Limpan/deskamp/DesktopAMP.kicad_pcb

## KiCad design DesktopAMP.kicad_pcb (2022-02-22)

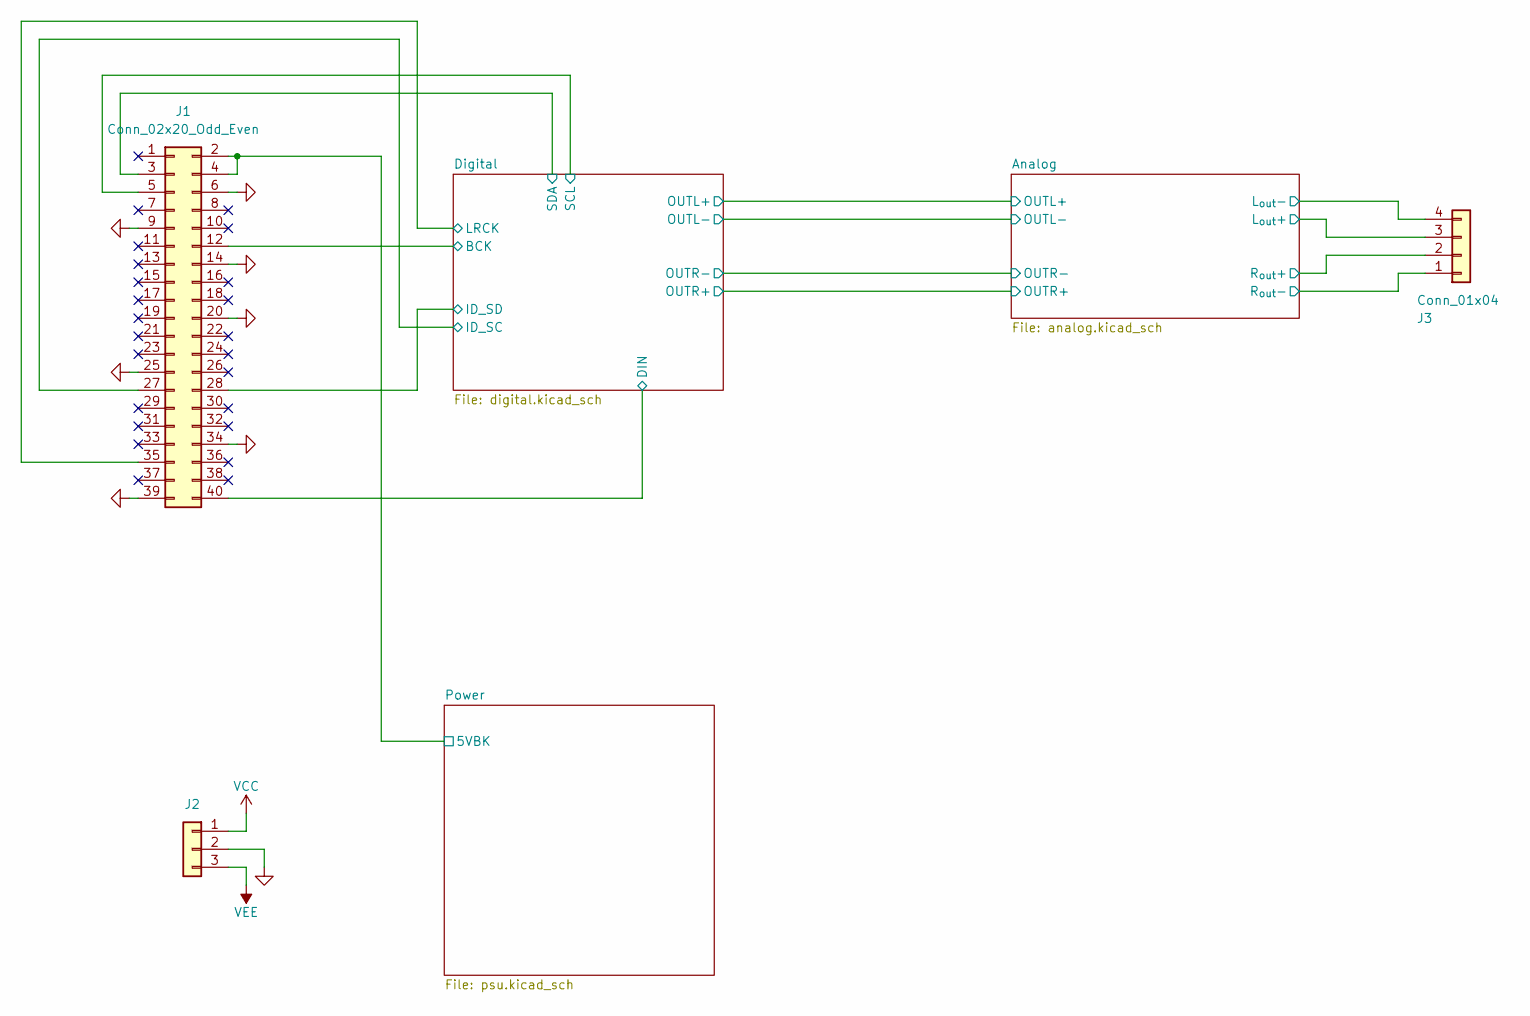
[picture p1: schematic DesktopAMP.kicad_sch]

Parts:
J1: Conn_02x20_Odd_Even; RPi_Zero_2W_SMD
J2: Conn_01x03; PhoenixContact_MSTBVA_2,5_3-G_1x03_P5.00mm_Vertical
J3: Conn_01x04; PhoenixContact_MSTBVA_2,5_4-G_1x04_P5.00mm_Vertical

Connections:
/Analog/L_{out}+: J3.3; also elsewhere on the board
/Analog/R_{out}+: J3.2; also elsewhere on the board
/Digital/BCK: J1.12; also elsewhere on the board
/Digital/DIN: J1.40; also elsewhere on the board
/Digital/ID_SC: J1.27; also elsewhere on the board
/Digital/ID_SD: J1.28; also elsewhere on the board
/Digital/LRCK: J1.35; also elsewhere on the board
/Digital/SCL: J1.5; also elsewhere on the board
/Digital/SDA: J1.3; also elsewhere on the board
/Power/5VBK: J1.2, J1.4; also elsewhere on the board
GND: J1.6, J1.9, J1.14, J1.20, J1.25, J1.34, J1.39, J2.2, J3.1, J3.4; also elsewhere on the board
VCC: J2.1; also elsewhere on the board
VEE: J2.3; also elsewhere on the board

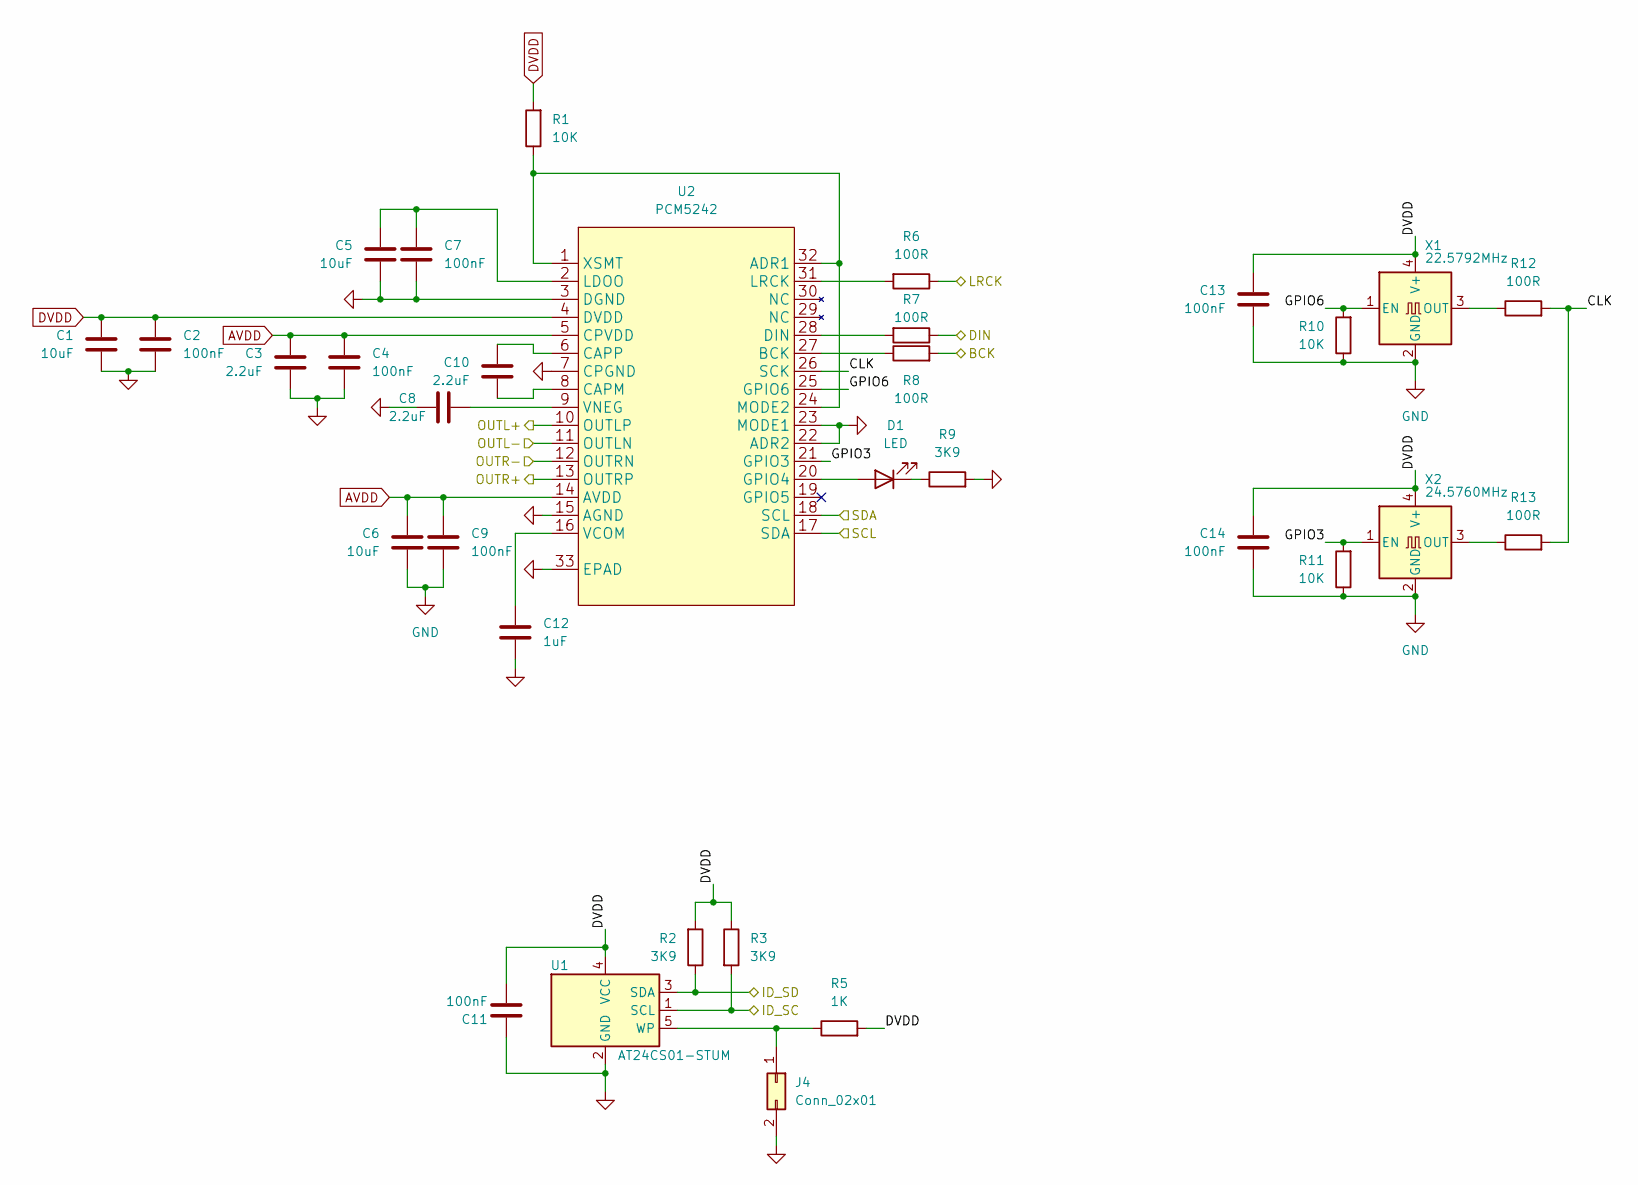
[picture p2: schematic digital.kicad_sch]

Parts:
C1, C5, C6: 10uF; C_0805_2012Metric
C2, C4, C7, C9, C11, C13, C14: 100nF; C_0603_1608Metric
C3, C8, C10: 2.2uF; C_0805_2012Metric
C12: 1uF; C_0805_2012Metric
D1: LED; LED_0805_2012Metric
J4: Conn_02x01; PinHeader_1x02_P2.54mm_Vertical
R1, R10, R11: 10K; R_0805_2012Metric
R2, R3, R9: 3K9; R_0805_2012Metric
R5: 1K; R_0805_2012Metric
R6, R7, R8, R12, R13: 100R; R_0805_2012Metric
U1: AT24CS01-STUM; SOT-23-5
U2: PCM5242; Texas_S-PVQFN-N32_EP3.45x3.45mm_ThermalVias
X1: 22.5792MHz; Oscillator_SMD_EuroQuartz_XO53-4Pin_5.0x3.2mm
X2: 24.5760MHz; Oscillator_SMD_EuroQuartz_XO53-4Pin_5.0x3.2mm

Connections:
/Analog/OUTL+: U2.10 (OUTLP); also elsewhere on the board
/Analog/OUTL-: U2.11 (OUTLN); also elsewhere on the board
/Analog/OUTR+: U2.13 (OUTRP); also elsewhere on the board
/Analog/OUTR-: U2.12 (OUTRN); also elsewhere on the board
/Digital/BCK: R8.2; also elsewhere on the board
/Digital/CLK: R12.2, R13.2, U2.26 (SCK)
/Digital/DIN: R7.1; also elsewhere on the board
/Digital/GPIO3: R11.2, U2.21 (GPIO3), X2.1 (EN)
/Digital/GPIO6: R10.2, U2.25 (GPIO6), X1.1 (EN)
/Digital/ID_SC: R3.2, U1.1 (SCL); also elsewhere on the board
/Digital/ID_SD: R2.1, U1.3 (SDA); also elsewhere on the board
/Digital/LRCK: R6.1; also elsewhere on the board
/Digital/SCL: U2.17 (SDA); also elsewhere on the board
/Digital/SDA: U2.18 (SCL); also elsewhere on the board
AVDD: C3.1, C4.1, C6.1, C9.1, U2.5 (CPVDD), U2.14 (AVDD); also elsewhere on the board
DVDD: C1.1, C2.1, C11.2, C13.2, C14.2, R1.2, R2.2, R3.1, R5.2, U1.4 (VCC), U2.4 (DVDD), X1.4 (V+), X2.4 (V+); also elsewhere on the board
GND: C1.2, C2.2, C3.2, C4.2, C5.2, C6.2, C7.2, C8.1, C9.2, C11.1, C12.2, C13.1, C14.1, J4.2, R9.2, R10.1, R11.1, U1.2 (GND), U2.3 (DGND), U2.7 (CPGND), U2.15 (AGND), U2.22 (ADR2), U2.23 (MODE1), U2.33 (EPAD), X1.2 (GND), X2.2 (GND); also elsewhere on the board
unnamed: C5.1, C7.1, U2.2 (LDOO)
unnamed: C8.2, U2.9 (VNEG)
unnamed: C10.1, U2.6 (CAPP)
unnamed: C10.2, U2.8 (CAPM)
unnamed: C12.1, U2.16 (VCOM)
unnamed: D1.1 (K), R9.1
unnamed: D1.2 (A), U2.20 (GPIO4)
unnamed: J4.1, R5.1, U1.5 (WP)
unnamed: R1.1, U2.1 (XSMT), U2.24 (MODE2), U2.32 (ADR1)
unnamed: R6.2, U2.31 (LRCK)
unnamed: R7.2, U2.28 (DIN)
unnamed: R8.1, U2.27 (BCK)
unnamed: R12.1, X1.3 (OUT)
unnamed: R13.1, X2.3 (OUT)

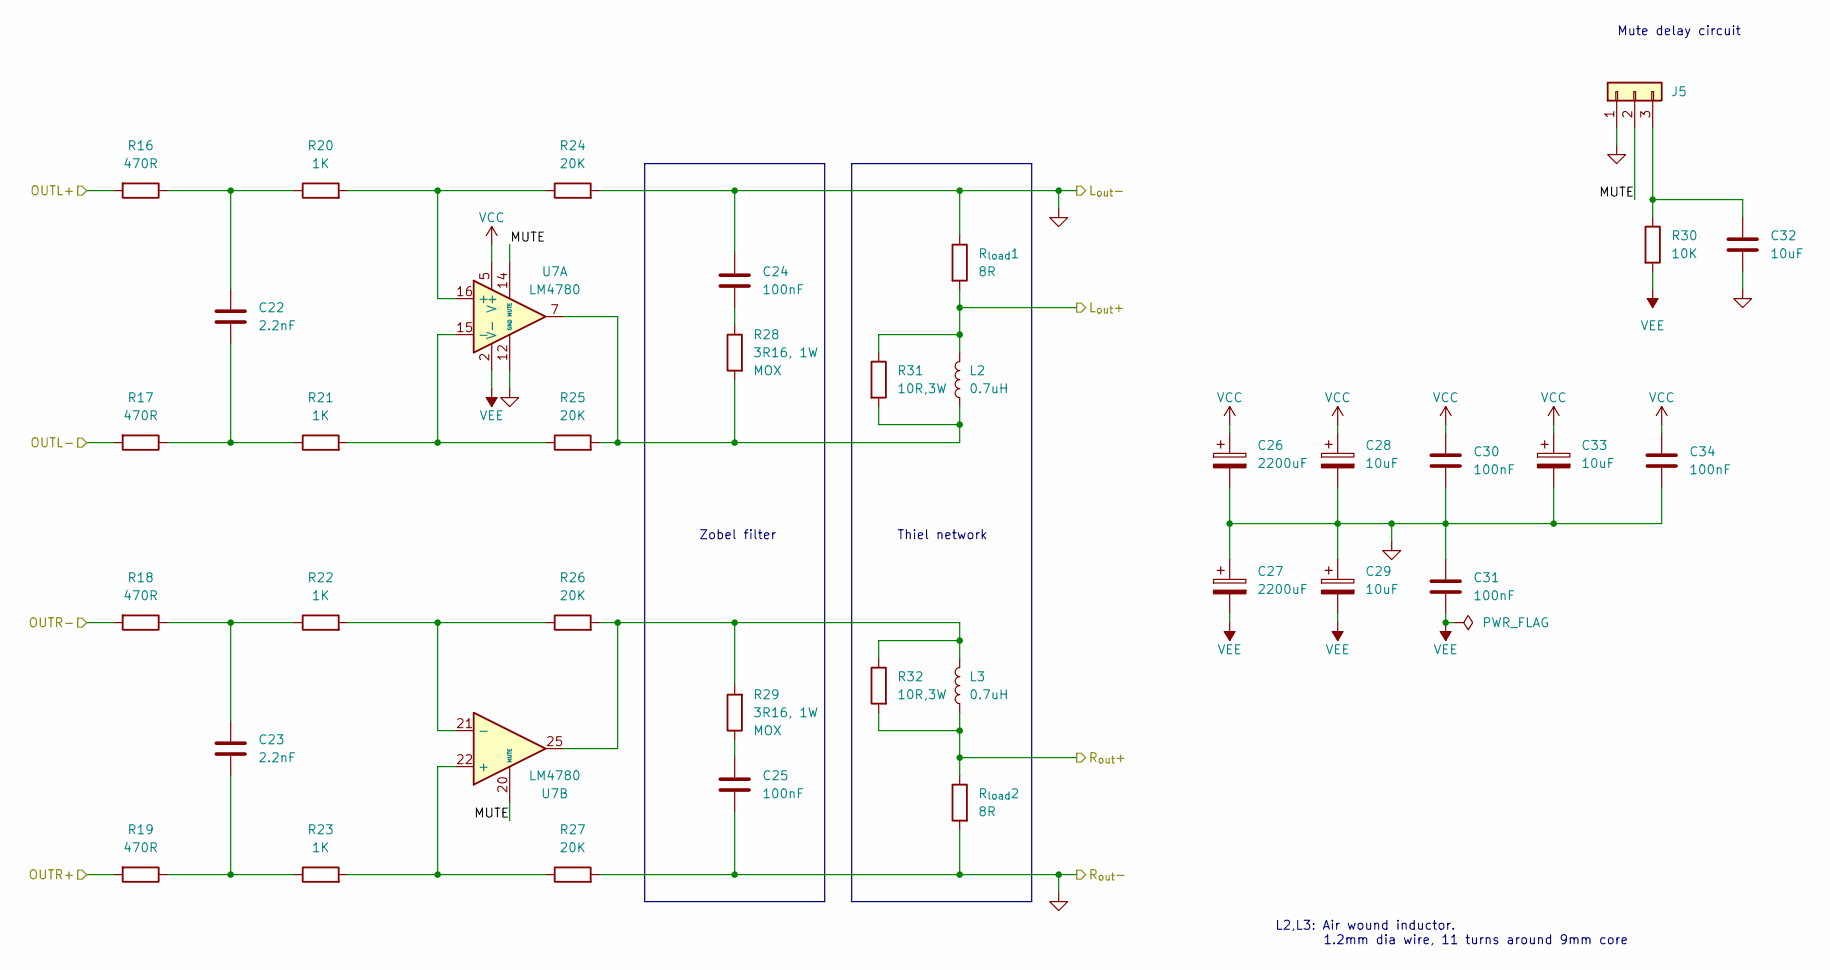
[picture p3: schematic analog.kicad_sch]

Parts:
C22, C23: 2.2nF; C_0805_2012Metric
C24, C25, C30, C31, C34: 100nF; C_Rect_L7.2mm_W2.5mm_P5.00mm_FKS2_FKP2_MKS2_MKP2
C26, C27: 2200uF; CP_Radial_D18.0mm_P7.50mm
C28, C29, C33: 10uF; CP_Radial_D6.3mm_P2.50mm
C32: 10uF; C_0805_2012Metric
J5: Conn_01x03; PinHeader_1x03_P2.54mm_Vertical
L2, L3: 0.7uH; L_Axial_L13.25_D11.4_P13.25_Horizontal
R16, R17, R18, R19: 470R; R_0805_2012Metric
R20, R23: 1K; R_0805_2012Metric
R21, R22: 1K; R_Axial_DIN0207_L6.3mm_D2.5mm_P7.62mm_Horizontal
R24, R25, R26, R27: 20K; R_0805_2012Metric
R28, R29: 3R16, 1W; R_Axial_DIN0309_L9.0mm_D3.2mm_P12.70mm_Horizontal
R30: 10K; R_0805_2012Metric
R31, R32: 10R,3W; R_Axial_DIN0617_L17.0mm_D6.0mm_P20.32mm_Horizontal
R_{load}1, R_{load}2: 8R
U7: LM4780; TO-220-27

Connections:
/Analog/L_{out}+: L2.2, R31.1, R_{load}1.2; also elsewhere on the board
/Analog/MUTE: J5.2, U7.14 (MUTE), U7.20 (MUTE)
/Analog/OUTL+: R16.2; also elsewhere on the board
/Analog/OUTL-: R17.2; also elsewhere on the board
/Analog/OUTR+: R19.2; also elsewhere on the board
/Analog/OUTR-: R18.2; also elsewhere on the board
/Analog/R_{out}+: L3.1, R32.2, R_{load}2.1; also elsewhere on the board
GND: C24.1, C25.2, C26.2, C27.1, C28.2, C29.1, C30.2, C31.2, C32.2, C33.2, C34.2, J5.1, R24.2, R27.2, R_{load}1.1, R_{load}2.2, U7.12 (GND), U7.19 (GND); also elsewhere on the board
unnamed: C22.1, R17.1, R21.1
unnamed: C22.2, R16.1, R20.1
unnamed: C23.1, R19.1, R23.1
unnamed: C23.2, R18.1, R22.1
unnamed: C24.2, R28.1
unnamed: C25.1, R29.1
unnamed: C32.1, J5.3, R30.1
unnamed: L2.1, R25.2, R28.2, R31.2, U7.7
unnamed: L3.2, R26.2, R29.2, R32.1, U7.25
unnamed: R20.2, R24.1, U7.16 (+)
unnamed: R21.2, R25.1, U7.15 (-)
unnamed: R22.2, R26.1, U7.21 (-)
unnamed: R23.2, R27.1, U7.22 (+)
VCC: C26.1, C28.1, C30.1, C33.1, C34.1, U7.5 (V+), U7.8 (V+), U7.9 (V+), U7.17 (V+), U7.27 (V+); also elsewhere on the board
VEE: C27.2, C29.2, C31.1, R30.2, U7.2 (V-), U7.4 (V-), U7.10 (V-), U7.11 (V-), U7.18 (V-); also elsewhere on the board

Notes on the sheet:
L2,L3: Air wound inductor. 1.2mm dia wire, 11 turns around 9mm core
Zobel filter
Mute delay circuit
Thiel network

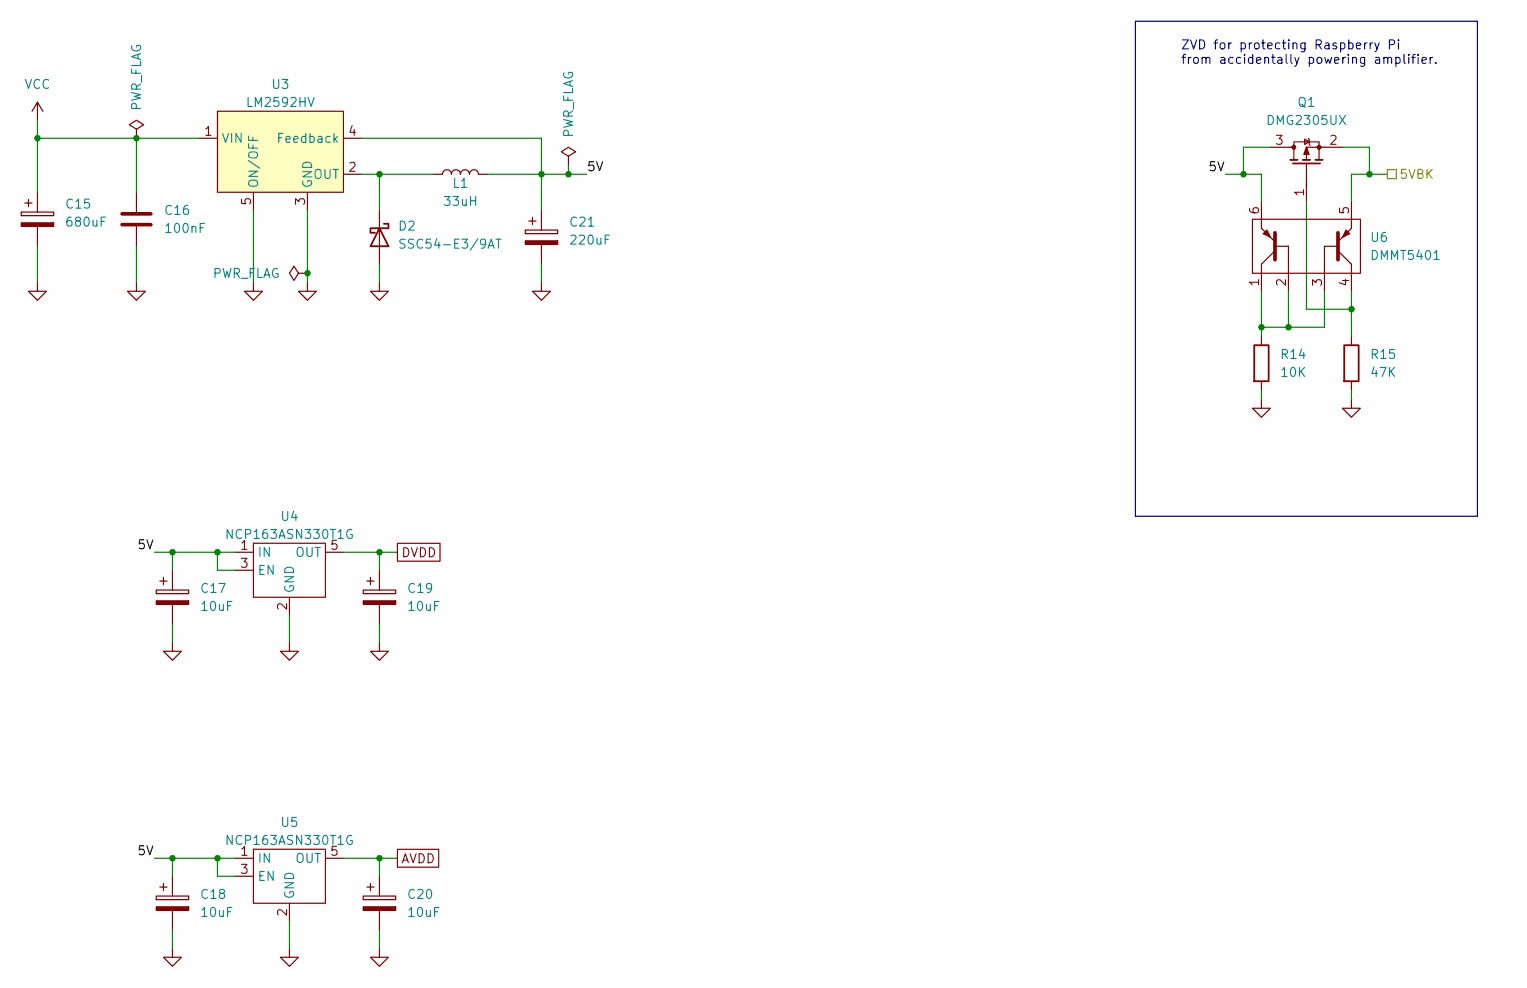
[picture p4: schematic psu.kicad_sch]

Parts:
C15: 680uF; CP_Radial_D10.0mm_P3.50mm
C16: 100nF; C_0603_1608Metric
C17, C18, C19, C20: 10uF; C_0805_2012Metric
C21: 220uF; CP_Radial_D8.0mm_P3.50mm
D2: SSC54-E3/9AT; D_SMC
L1: 33uH; L_Bourns_SRR1260
Q1: DMG2305UX; SOT-23
R14: 10K; R_0805_2012Metric
R15: 47K; R_0805_2012Metric
U3: LM2592HV; TO-263-5_TabPin3
U4, U5: NCP163ASN330T1G; SOT-23-5
U6: DMMT5401; SOT-23-6

Connections:
/Power/5V: C17.1, C18.1, C21.1, L1.2, Q1.3, U3.4 (Feedback), U4.1 (IN), U4.3 (EN), U5.1 (IN), U5.3 (EN), U6.6
/Power/5VBK: Q1.2, U6.5; also elsewhere on the board
AVDD: C20.1, U5.5 (OUT); also elsewhere on the board
DVDD: C19.1, U4.5 (OUT); also elsewhere on the board
GND: C15.2, C16.2, C17.2, C18.2, C19.2, C20.2, C21.2, D2.2 (A), R14.2, R15.2, U3.3 (GND), U3.5 (ON/OFF), U4.2 (GND), U4.4 (NC), U5.2 (GND), U5.4 (NC); also elsewhere on the board
unnamed: D2.1 (K), L1.1, U3.2 (OUT)
unnamed: Q1.1, R15.1, U6.4
unnamed: R14.1, U6.1, U6.2, U6.3
VCC: C15.1, C16.1, U3.1 (VIN); also elsewhere on the board

Notes on the sheet:
ZVD for protecting Raspberry Pi from accidentally powering amplifier.

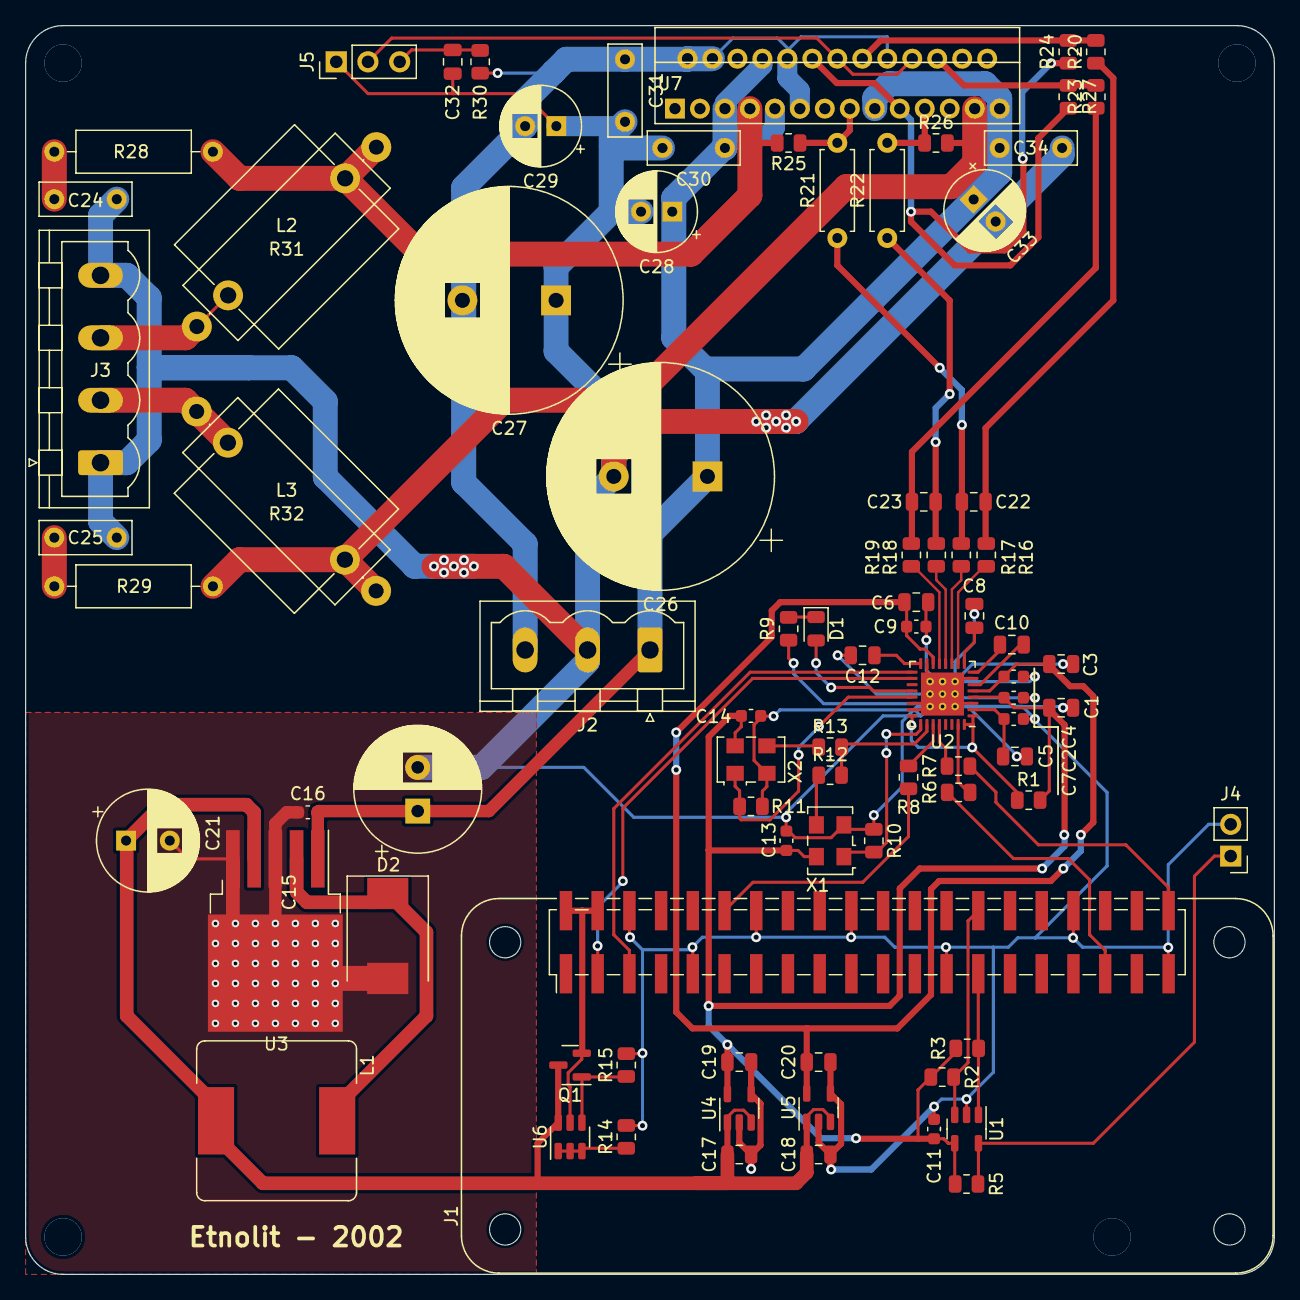
[picture p5: board DesktopAMP.kicad_pcb from above]

Board: 2 copper layers, 100.0 x 100.0 mm, 85 parts (0 on the bottom side), 54 nets.
