Limpan/deskamp/(commit log)

2022-02-06 Project setup.
    [DesktopAMP.kicad_pcb, DesktopAMP.kicad_sch]
2022-02-07 Added LM4780.
    [DesktopAMP.kicad_sch]
2022-02-07 Added footprints to all components.
    [DesktopAMP.kicad_sch]
2022-02-08 Footprints for all components.
    [DesktopAMP.kicad_pcb, DesktopAMP.kicad_sch]
2022-02-08 Worked on placement and footprints.
    [DesktopAMP.kicad_pcb, DesktopAMP.kicad_sch]
2022-02-09 Begun splitting schematic into multiple sheets.
    [DesktopAMP.kicad_pcb, DesktopAMP.kicad_sch, analog.kicad_sch, digital.kicad_sch, psu.kicad_sch]
